proveskit/antenna-board/antenna_top_cap_v2d/jlcpcb/production_files/BOM-antenna_top_cap_v2d.csv

Comment | Designator | Footprint | LCSC | Quantity
ATB2012-50011-T000 | B1 | XFMR-SMD_ATB2012-50011-T000 | C92015 | 1
1uF | C201 | C_0603_1608Metric | C15849 | 1
22uF | C202 | C_0805_2012Metric | C45783 | 1
22uF | C204,C205,C206,C207 | C_1206_3216Metric | C12891 | 4
47nF | C208 | C_0603_1608Metric | C1622 | 1
4.7uF | C209 | C_0603_1608Metric | C19666 | 1
100nF | C43,C5 | C_0805_2012Metric | C28233 | 2
Blue | D1 | LED_0603_1608Metric | C2288 | 1
Green | D201 | LED_0805_2012Metric | C2297 | 1
Red | D202 | LED_0603_1608Metric | C2286 | 1
1.5A | F201 | Fuse_1206_3216Metric | C187598 | 1
DEBUG | J1 | Hirose_DF11-12DP-2DSA_2x06_P2.00mm_Vertical | C506658 | 1
DF11-4DP-2DSA | J11,J9 | Hirose_DF11-4DP-2DSA_2x02_P2.00mm_Vertical | C506665 | 2
USB_C_Receptacle_USB2.0_16P | J12,J204,J8 | USB_C_Receptacle_HRO_TYPE-C-31-M-12 | C165948 | 3
DNP | J13 | Hirose_DF11-4DP-2DSA_2x02_P2.00mm_Vertical |  | 1
SWD from FC | J201,J202 | JST_SH_BM03B-SRSS-TB_1x03-1MP_P1.00mm_Vertical | C160389 | 2
1uH | L201 | L_Changjiang_FNR4030S | C167865 | 1
CSD17576Q5B | Q2 | TDSON-8-1 | C2876547 | 1
10k | R1,R204 | R_0402_1005Metric | C25744 | 2
10k | R10,R11,R8,R9 | R_0603_1608Metric | C25804 | 4
3.9k | R201 | R_0402_1005Metric | C51721 | 1
820 | R202 | R_0402_1005Metric | C25135 | 1
0 | R203 | R_0402_1005Metric | C17168 | 1
12k | R205 | R_0402_1005Metric | C25752 | 1
4.7k | R206 | R_0603_1608Metric | C23162 | 1
2.2k | R207 | R_0603_1608Metric | C4190 | 1
5.1k | R208,R209,R26,R27,R5,R6 | R_0603_1608Metric | C23186 | 6
0 | R210 | R_1206_3216Metric | C17888 | 1
1M | R7 | R_0603_1608Metric | C22935 | 1
KH-MMCX-Z | RF1 | MMCX-TH_KH-MMCX-Z | C530664 | 1
BQ25886RGER | U201 | Texas_RGE0024H_VQFN-24-1EP_4x4mm_P0.5mm_EP2.7x2.7mm | C2765094 | 1
VEML6031X00 | U3 | SENSOR-SMD_VEML6031X00 | C3678616 | 1
TMP112xxDRL | U4 | SOT-563 | C3019122 | 1
TCA4311ADGKR | U6 | MSOP-8_L3.0-W3.0-P0.65-LS5.0-BL | C130025 | 1
