proveskit/antenna-board/antenna_top_cap_v2c/Extra Libraries Folder/CD74HC4050M96/CD74HC4050M96.step

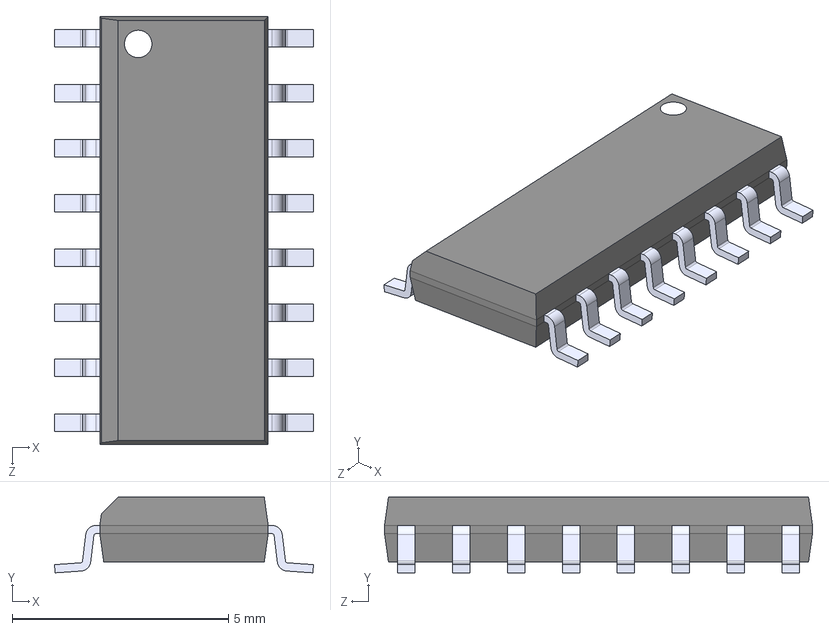
[picture p1: CAD file, 2026-09-02]
antenna_top_cap_v2c/Extra Libraries Folder/CD74HC4050M96/CD74HC4050M96.step
5.99 x 1.75 x 9.91 mm
