proveskit/antenna-board/antenna_top_cap_v2c/Extra Libraries Folder/LIB_AZ1117CH-3.3TRG1 (1)/AZ1117CH-3.3TRG1/3D/AZ1117CH-3.3TRG1.stp

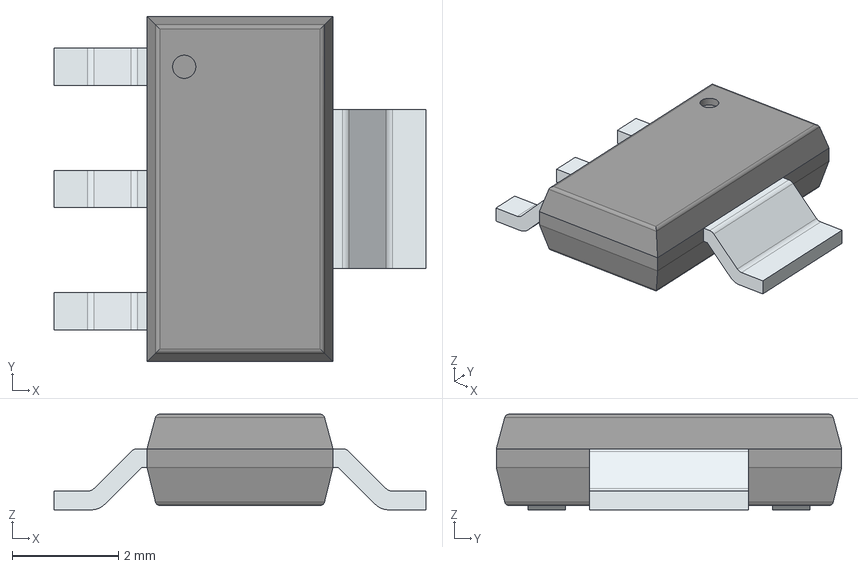
[picture p2: CAD file, 2026-09-02]
antenna_top_cap_v2c/Extra Libraries Folder/LIB_AZ1117CH-3.3TRG1 (1)/AZ1117CH-3.3TRG1/3D/AZ1117CH-3.3TRG1.stp
7.00 x 6.50 x 1.80 mm
PinsArrayL
FilletPinR
