proveskit/antenna-board/antenna_top_cap_v2c/Extra Libraries Folder/105164-0001 (1)/105164-0001.step

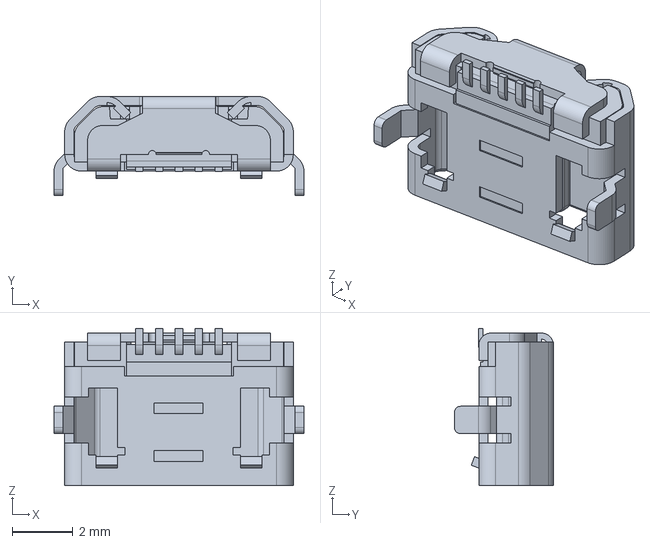
[picture p3: CAD file, 2026-09-02]
antenna_top_cap_v2c/Extra Libraries Folder/105164-0001 (1)/105164-0001.step
8.20 x 3.25 x 5.15 mm
