proveskit/antenna-board/antenna_top_cap_v2c/Extra Libraries Folder/504050-0291/504050-0291.step

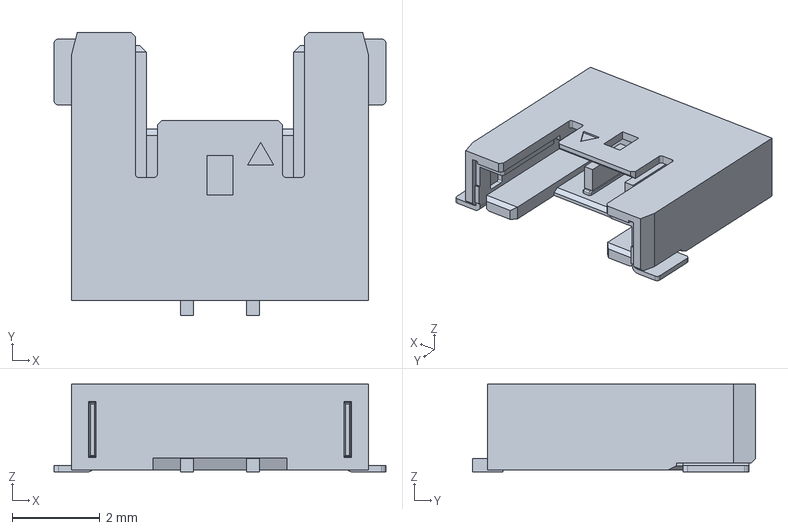
[picture p4: CAD file, 2026-09-02]
antenna_top_cap_v2c/Extra Libraries Folder/504050-0291/504050-0291.step
7.55 x 6.44 x 2.00 mm
