proveskit/antenna-board/antenna_top_cap_v2c/Extra Libraries Folder/LIB_104031-0811/104031-0811/3D/104031-0811.stp

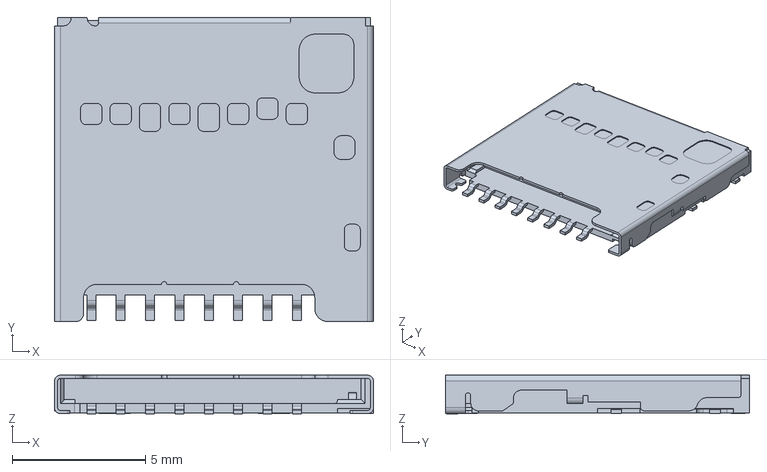
[picture p5: CAD file, 2026-09-02]
antenna_top_cap_v2c/Extra Libraries Folder/LIB_104031-0811/104031-0811/3D/104031-0811.stp
11.9 x 11.4 x 1.45 mm
