proveskit/antenna-board/(list of files, cad)

Other CAD files:
antenna_top_cap_v2c/Extra Libraries Folder/LIB_104031-0811/104031-0811/Allegro/1040310811.psm
antenna_top_cap_v2c/Extra Libraries Folder/LIB_104031-0811/104031-0811/DEHDL/104031_0811/chips/chips.prt
antenna_top_cap_v2c/Extra Libraries Folder/LIB_AZ1117CH-3.3TRG1 (1)/AZ1117CH-3.3TRG1/Allegro/sot230p700x180-4n.psm
antenna_top_cap_v2c/Extra Libraries Folder/LIB_AZ1117CH-3.3TRG1 (1)/AZ1117CH-3.3TRG1/DEHDL/az1117ch_3.3trg1/chips/chips.prt
