proveskit/antenna-board/(threads)

Thread 1 (2024-06-18):

Selecting the Location of the 12-Pin Picolock

Mikefly123, 2024-06-18:
I have initially placed it towards the center of the board, but Pragun has requested it move like the attached image. Any thoughts?

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

Mikefly123, 2024-06-19:
Testing out this team thing. @proveskit/avionics-team

Closed 2024-07-16.

Thread 2 (2024-06-18):

Auxiliary Antenna Feed Path Causing Huge Losses

Mikefly123, 2024-06-18:
So the way that we are currently doing the Aux Radio Module Antenna feed seems to be causing huge losses compared to just a straight feed path. Somewhere in the neighborhood of -10 to -14dB in the RSSI in our testing at the lab. We need to address this, probably by changing out the RF switch IC being used to have it inline rather than off to the side.

Thread 3 (2024-06-18):

Our Baluns Are Hoodwinking Us!

Mikefly123, 2024-06-18:
For the last two years we have been kind of blindly using whatever Balun looks like it has a decent insertion loss for our intended frequency. The problem with this is that we didn't really have a great understanding of what Baluns actually do and how they work.

Because we have been trying to use 1:4 Baluns like this:

https://www.johansontechnology.com/datasheets/0433BM15A0001/0433BM15A0001.pdf

We are running into an impedance mismatch on the balanced port. Parts like the above linked balun output 200 Ohms on the balanced port, whereas we really want something that is closer to the 72 ohm impedance of an ideal dipole.

Mikefly123, 2024-06-18:
We might want to swap to a part like this?

https://www.minicircuits.com/pdfs/NCS1.5-232+.pdf

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

More Research Needed

Mikefly123, 2024-06-18:
Also, a reference to what the title means haha

https://youtu.be/-B3gjf0sREk?si=o_he7N_A1IsG9HRs

Mikefly123, 2024-06-20:
Confirming that we are swapping to the NCS1.5-232+ for future antenna boards. Updates to the schematic and layout for this have been made in Commit https://github.com/proveskit/antenna-board/commit/264a7582f32f4466c49b9e7e7279876b0408b85f

Mikefly123, 2024-06-20:
This update will merge with main after Issue #4 is complete!

Closed 2024-06-20.

Thread 4 (2024-06-19):

Antenna Top Cap Version 2

Mikefly123, 2024-06-19:
Whipping up an entirely new version of the antenna top cap! Hoping to significantly improve the antenna feed path with better part selection and also roll up significant quality of life improvements by consolidating many of the connectors.

Mikefly123, 2024-06-19:
First major update is the schematic. See details in Issue #5

Closed 2024-06-24.

Thread 5 (2024-06-19):

Confusing Schematic

Mikefly123, 2024-06-19:
The usual, our first version has a very confusingly laid out schematic. See attached:
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

Mikefly123, 2024-06-19:
This was fixed for V2 in Commit https://github.com/proveskit/antenna-board/commit/d93f40ee3b1451b6ce820f76784fe6274ac24dea.

See the new schematic here!
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

Closed 2024-06-19.

Thread 6 (2024-06-20):

All of the SDA1 Nets Have Been Renamed to SCL1

Mikefly123, 2024-06-20:
This is really annoying, not sure why this happened! We might have to reroute everything:

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

Mikefly123, 2024-06-20:
# Hotfix

Hotfixed by renaming the nets from SCL to SDA. This appears to have corrected everything. We need to make sure to verify all the connections before shipping!

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

NicoleMaggard, 2024-06-20:
Before:
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
After:
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

Closed 2024-06-20.

Thread 7 (2024-06-20):

5 position picolock suggestion

NicoleMaggard, 2024-06-20:
you should totally add a 5 position picolock header for the flight computer to communicate with the USB pins similar to how the 12 position picolock is setup for the battery board

Mikefly123, 2024-06-24:
It is done

Closed 2024-06-24.

Thread 9 (2024-06-23):

RBF Hole Spacing on the Antenna Board

Mikefly123, 2024-06-23:
Is the spacing on these holes correct or do they need to be spread out more?

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

Thread 11 (2024-07-07):

C1 Clearance

Mikefly123, 2024-07-07:
The C1 Capacitor on the Antenna Board is too close to the 12-pos Molex connector. It doesn't block insertion but makes it awkward.
