proveskit/antenna-board/(list of files, drawings)

Other design files:
antenna_top_cap_v2c/Extra Libraries Folder/LIB_104031-0811/104031-0811/Altium/104031-0811.SchLib
antenna_top_cap_v2c/Extra Libraries Folder/LIB_104031-0811/104031-0811/Altium/1040310811.PcbLib
antenna_top_cap_v2c/Extra Libraries Folder/LIB_AZ1117CH-3.3TRG1 (1)/AZ1117CH-3.3TRG1/Altium/AZ1117CH-3.3TRG1.SchLib
antenna_top_cap_v2c/Extra Libraries Folder/LIB_AZ1117CH-3.3TRG1 (1)/AZ1117CH-3.3TRG1/Altium/SOT230P700X180-4N.PcbLib
