proveskit/antenna-board/antenna_top_cap_v2d/antenna_top_cap_v2d.kicad_pcb

## KiCad design antenna_top_cap_v2d/antenna_top_cap_v2d.kicad_pcb (2026-11-12)

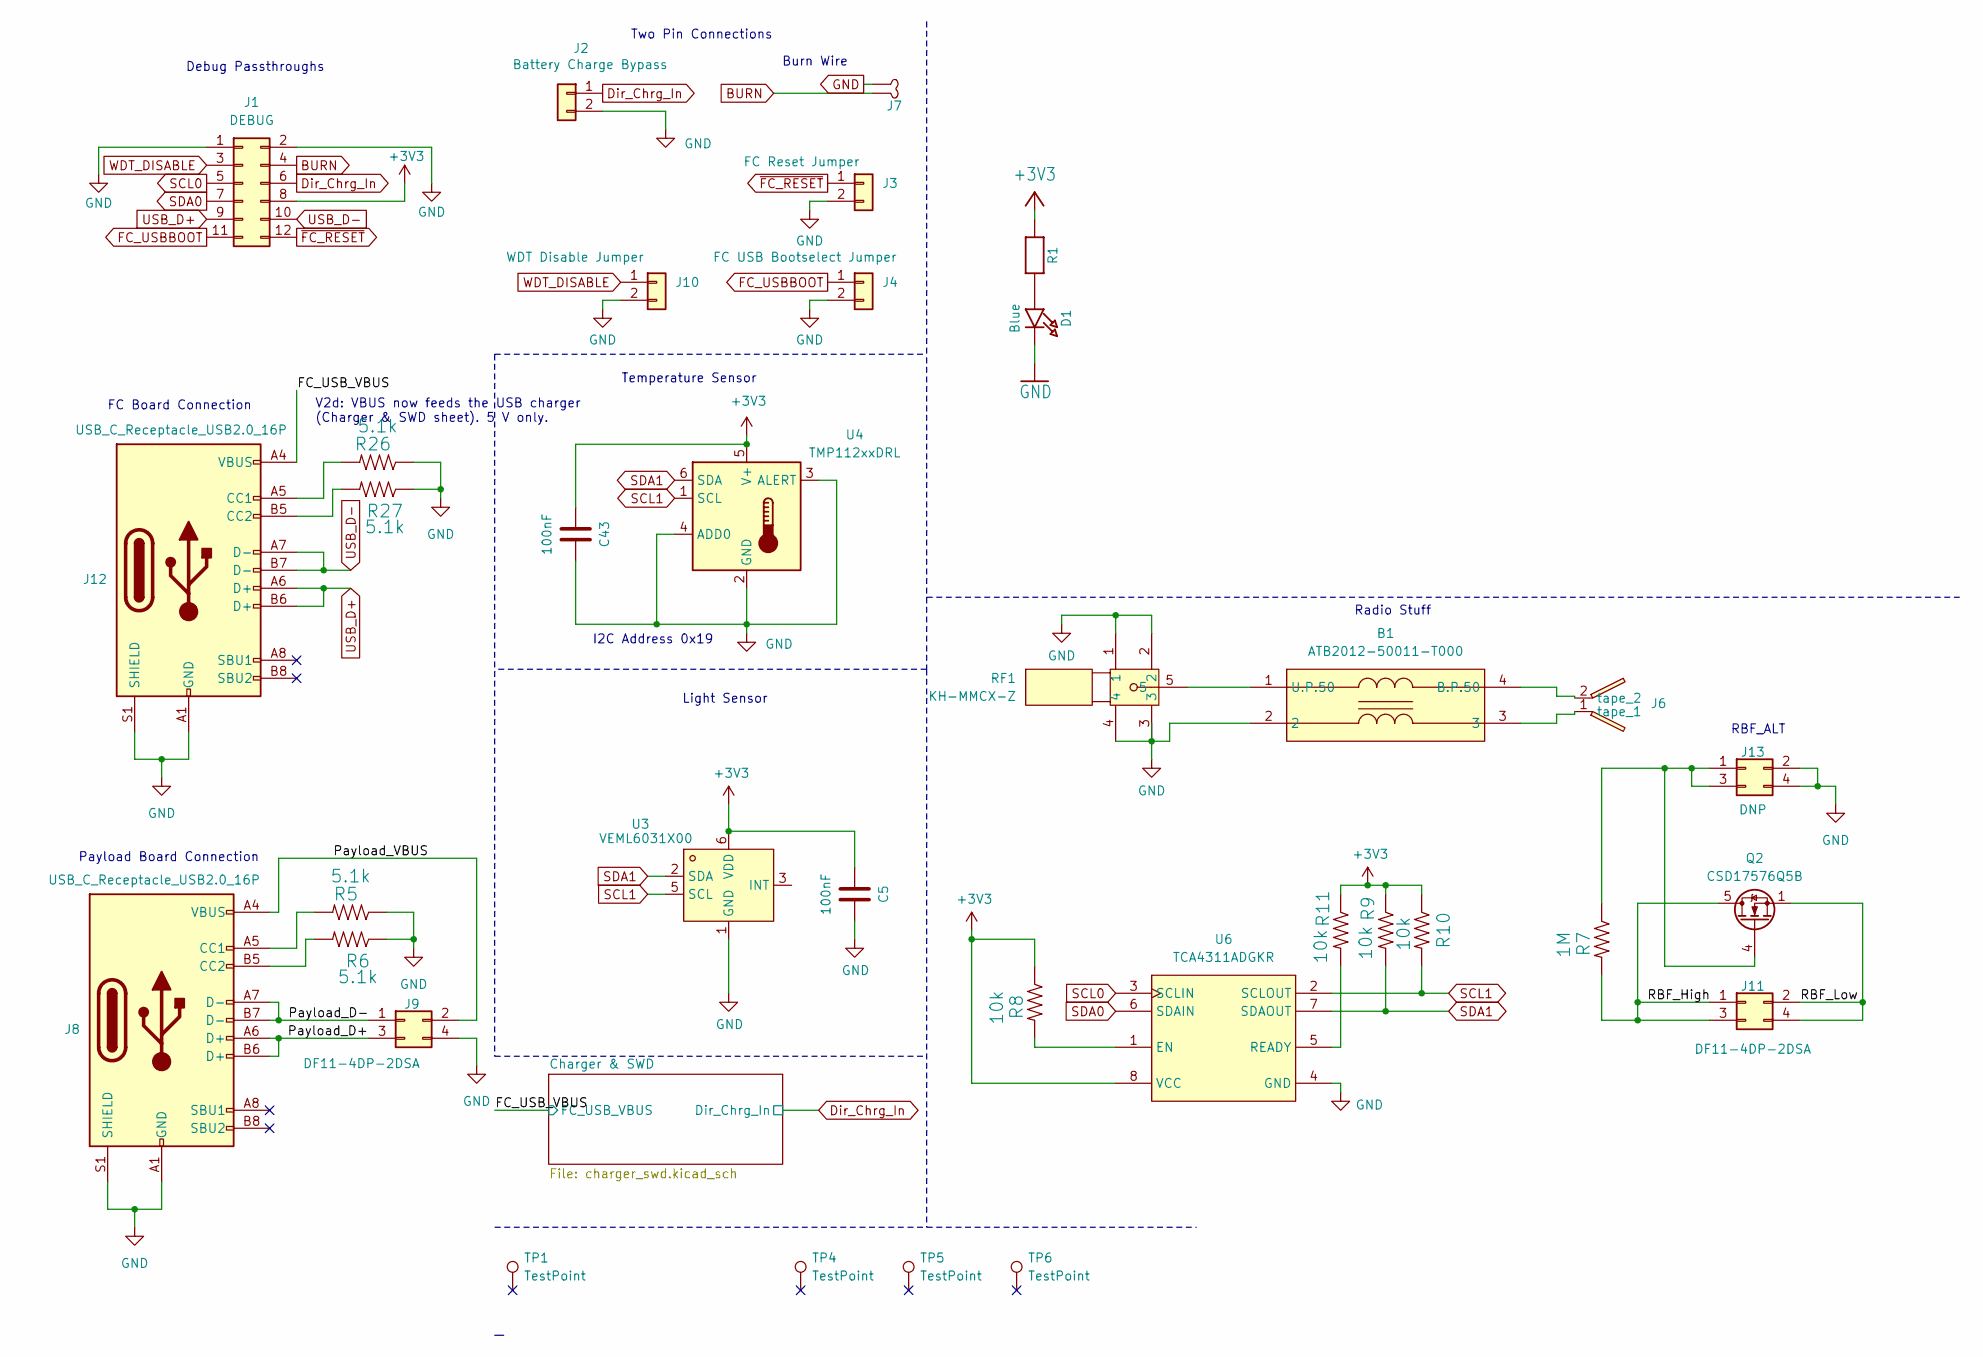
[picture p6: schematic antenna_top_cap_v2d.kicad_sch, PROVES Antenna Board V2d]

Parts:
B1: ATB2012-50011-T000; XFMR-SMD_ATB2012-50011-T000; LCSC Part C92015
C5, C43: 100nF; C_0805_2012Metric
D1: Blue; LED_0603_1608Metric
J1: DEBUG; Hirose_DF11-12DP-2DSA_2x06_P2.00mm_Vertical
J2: Battery Charge Bypass; PinHeader_1x02_P2.54mm_Vertical
J3: FC Reset Jumper; PinHeader_1x02_P2.54mm_Vertical
J4: FC USB Bootselect Jumper; PinHeader_1x02_P2.54mm_Vertical
J6: Tape_Measure_Antenna
J7: Burn_Wire
J8, J12: USB_C_Receptacle_USB2.0_16P; USB_C_Receptacle_HRO_TYPE-C-31-M-12
J9, J11: DF11-4DP-2DSA; Hirose_DF11-4DP-2DSA_2x02_P2.00mm_Vertical
J10: WDT Disable Jumper; PinHeader_1x02_P2.54mm_Vertical
J13: DNP; Hirose_DF11-4DP-2DSA_2x02_P2.00mm_Vertical
Q2: CSD17576Q5B; TDSON-8-1
R1: 10k; R_0402_1005Metric
R5, R6, R26, R27: 5.1k; R_0603_1608Metric
R7: 1M; R_0603_1608Metric
R8, R9, R10, R11: 10k; R_0603_1608Metric
RF1: KH-MMCX-Z; MMCX-TH_KH-MMCX-Z; LCSC Part C530664
TP1, TP4, TP5, TP6: TestPoint; MountingHole_2.7mm_M2.5_Pad
U3: VEML6031X00; SENSOR-SMD_VEML6031X00; LCSC Part C3678616
U4: TMP112xxDRL; SOT-563
U6: TCA4311ADGKR; MSOP-8_L3.0-W3.0-P0.65-LS5.0-BL; LCSC Part C130025

Connections:
+3V3: C5.1, C43.1, J1.8, R1.1, R8.1, R9.1, R10.1, R11.1, U3.6 (VDD), U4.5 (V+), U6.8 (VCC)
/Payload_D+: J8.A6 (D+), J8.B6 (D+), J9.3
/Payload_D-: J8.A7 (D-), J8.B7 (D-), J9.1
/Payload_VBUS: J8.A4 (VBUS), J8.A9 (VBUS), J8.B4 (VBUS), J8.B9 (VBUS), J9.2
/RBF_High: J11.1, J11.3, Q2.5 (D), R7.2
/RBF_Low: J11.2, J11.4, Q2.1 (S), Q2.2 (S), Q2.3 (S)
BURN: J1.4, J7.1 (Power)
Dir_Chrg_In: J1.6, J2.1; also elsewhere on the board
FC_USBBOOT: J1.11, J4.1
GND: B1.2, C5.2, C43.2, D1.2 (C), J1.1, J1.2, J2.2, J3.2, J4.2, J7.2 (GND), J8.A1 (GND), J8.A12 (GND), J8.B1 (GND), J8.B12 (GND), J8.S1 (SHIELD), J9.4, J10.2, J12.A1 (GND), J12.A12 (GND), J12.B1 (GND), J12.B12 (GND), J12.S1 (SHIELD), J13.2, J13.4, R5.1, R6.1, R26.1, R27.1, RF1.1, RF1.2, RF1.3, RF1.4, U3.1 (GND), U3.4 (GND), U4.2 (GND), U4.3 (ALERT), U4.4 (ADD0), U6.4 (GND); also elsewhere on the board
unnamed: B1.4 (B.P.50), J6.2 (tape)
unnamed: B1.1 (U.P.50), RF1.5
unnamed: D1.1 (A), R1.2
unnamed: B1.3, J6.1 (tape)
unnamed: J8.A5 (CC1), R5.2
unnamed: J8.B5 (CC2), R6.2
unnamed: J12.A5 (CC1), R26.2
unnamed: J12.B5 (CC2), R27.2
unnamed: J13.1, J13.3, Q2.4 (G), R7.1
unnamed: R8.2, U6.1 (EN)
unnamed: R11.2, U6.5 (READY)
SCL0: J1.5, U6.3 (SCLIN)
SCL1: R10.2, U3.5 (SCL), U4.1 (SCL), U6.2 (SCLOUT)
SDA0: J1.7, U6.6 (SDAIN)
SDA1: R9.2, U3.2 (SDA), U4.6 (SDA), U6.7 (SDAOUT)
USB_D+: J1.9, J12.A6 (D+), J12.B6 (D+)
USB_D-: J1.10, J12.A7 (D-), J12.B7 (D-)
WDT_DISABLE: J1.3, J10.1
~FC_RESET: J1.12, J3.1

Notes on the sheet:
Light Sensor
Two Pin Connections
I2C Address 0x19
Radio Stuff
Debug Passthroughs
FC Board Connection
RBF_ALT
Payload Board Connection
Burn Wire
Temperature Sensor
V2d: VBUS now feeds the USB charger (Charger & SWD sheet). 5 V only.

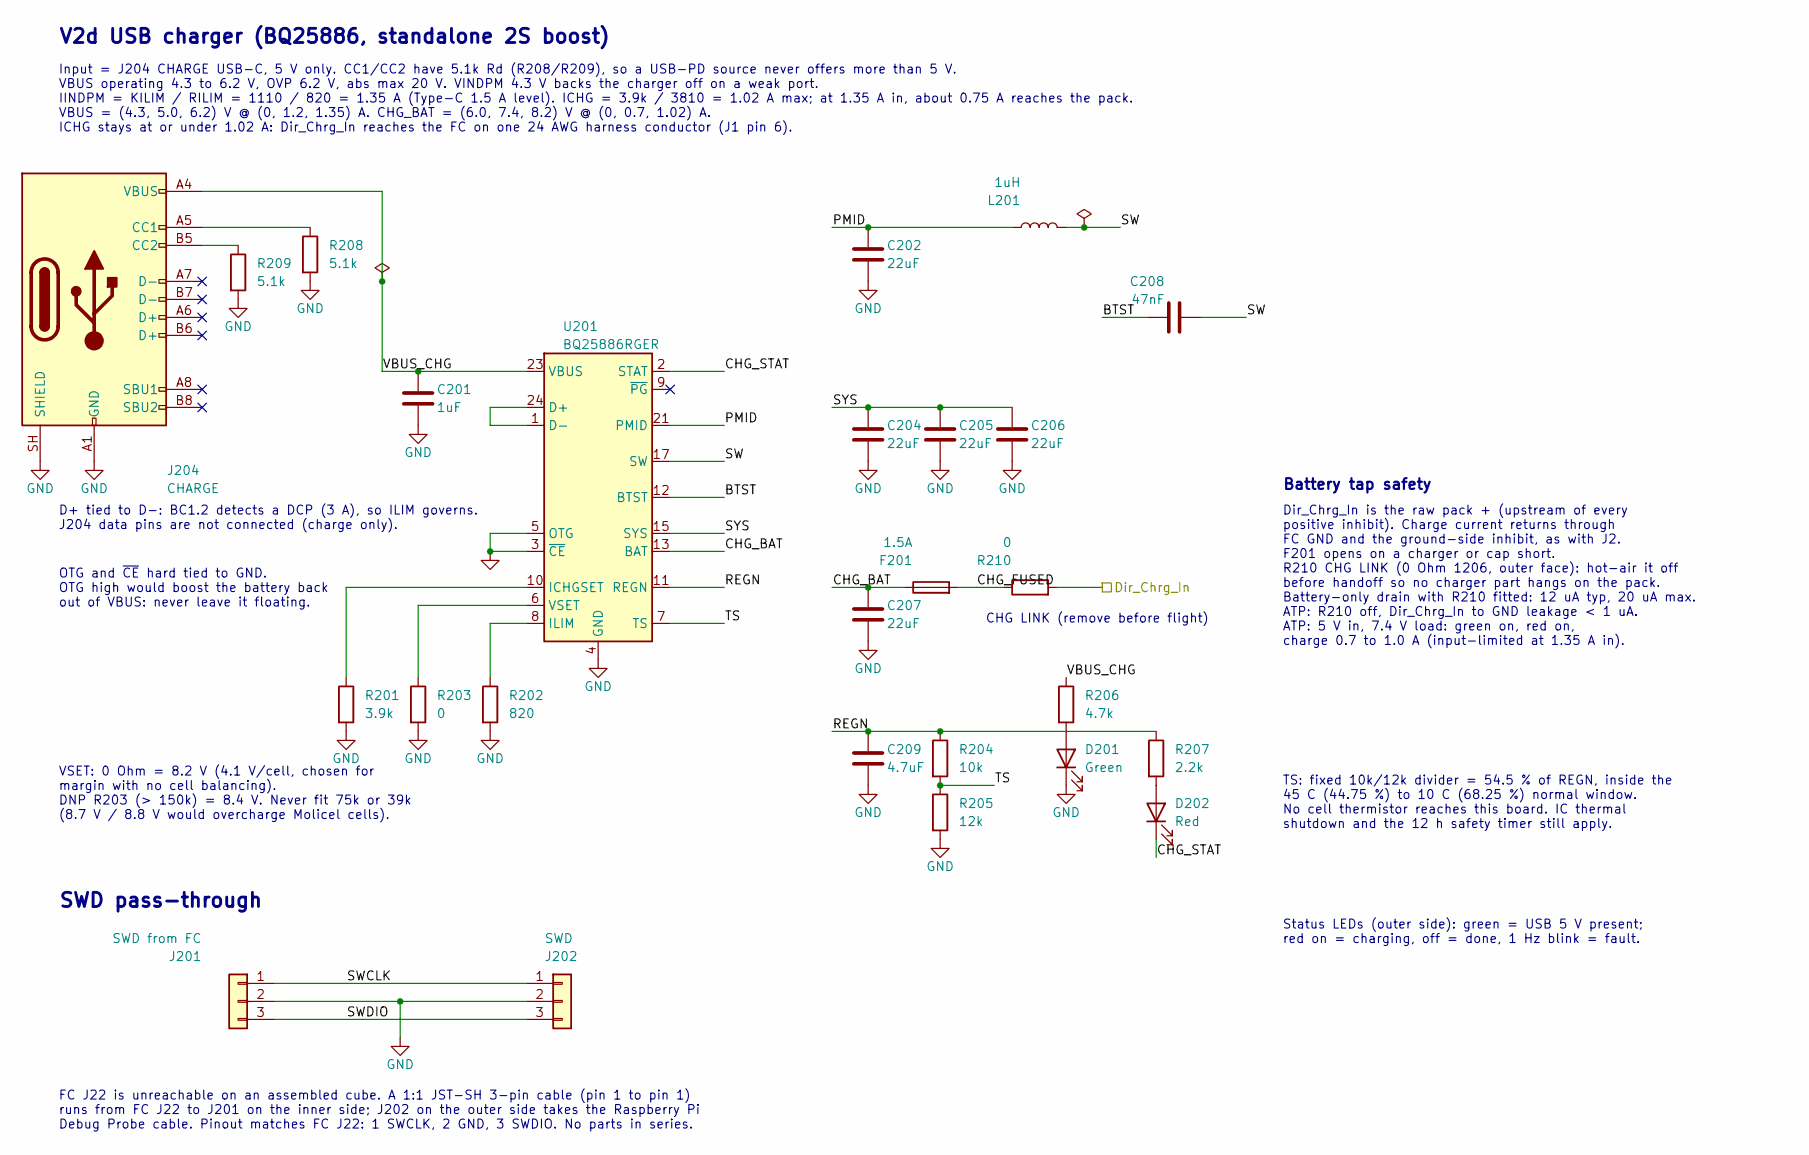
[picture p7: schematic charger_swd.kicad_sch, Antenna Board V2d: USB charger and SWD pass-through]

Parts:
C201: 1uF; C_0603_1608Metric; LCSC C15849
C202: 22uF; C_0805_2012Metric; LCSC C45783
C204, C205, C206, C207: 22uF; C_1206_3216Metric; LCSC C12891
C208: 47nF; C_0603_1608Metric; LCSC C1622
C209: 4.7uF; C_0603_1608Metric; LCSC C19666
D201: Green; LED_0805_2012Metric; LCSC C2297
D202: Red; LED_0603_1608Metric; LCSC C2286
F201: 1.5A; Fuse_1206_3216Metric; MPN 046601.5NRHF; LCSC C187598
J201: SWD from FC; JST_SH_BM03B-SRSS-TB_1x03-1MP_P1.00mm_Vertical; MPN BM03B-SRSS-TB(LF)(SN); LCSC C160389
J202: SWD; JST_SH_BM03B-SRSS-TB_1x03-1MP_P1.00mm_Vertical; MPN BM03B-SRSS-TB(LF)(SN); LCSC C160389
J204: CHARGE; USB_C_Receptacle_HRO_TYPE-C-31-M-12; MPN TYPE-C-31-M-12; LCSC C165948
L201: 1uH; L_Changjiang_FNR4030S; MPN FNR4030S1R0MT; LCSC C167865
R201: 3.9k; R_0402_1005Metric; LCSC C51721
R202: 820; R_0402_1005Metric; LCSC C25135
R203: 0; R_0402_1005Metric; LCSC C17168
R204: 10k; R_0402_1005Metric; LCSC C25744
R205: 12k; R_0402_1005Metric; LCSC C25752
R206: 4.7k; R_0603_1608Metric; LCSC C23162
R207: 2.2k; R_0603_1608Metric; LCSC C4190
R208, R209: 5.1k; R_0603_1608Metric; LCSC C23186
R210: 0; R_1206_3216Metric; LCSC C17888
U201: BQ25886RGER; Texas_RGE0024H_VQFN-24-1EP_4x4mm_P0.5mm_EP2.7x2.7mm; LCSC C2765094

Connections:
/Charger & SWD/BTST: C208.1, U201.12 (BTST)
/Charger & SWD/CHG_BAT: C207.1, F201.1, U201.13 (BAT), U201.14 (BAT)
/Charger & SWD/CHG_FUSED: F201.2, R210.1
/Charger & SWD/CHG_STAT: D202.1 (K), U201.2 (STAT)
/Charger & SWD/PMID: C202.1, L201.1, U201.21 (PMID), U201.22 (PMID)
/Charger & SWD/REGN: C209.1, R204.1, R207.1, U201.11 (REGN)
/Charger & SWD/SW: C208.2, L201.2, U201.17 (SW), U201.18 (SW)
/Charger & SWD/SWCLK: J201.1, J202.1
/Charger & SWD/SWDIO: J201.3, J202.3
/Charger & SWD/SYS: C204.1, C205.1, C206.1, U201.15 (SYS), U201.16 (SYS)
/Charger & SWD/TS: R204.2, R205.1, U201.7 (TS)
/Charger & SWD/VBUS_CHG: C201.1, J204.A4 (VBUS), J204.A9 (VBUS), J204.B4 (VBUS), J204.B9 (VBUS), R206.1, U201.23 (VBUS)
Dir_Chrg_In: R210.2; also elsewhere on the board
GND: C201.2, C202.2, C204.2, C205.2, C206.2, C207.2, C209.2, D201.1 (K), J201.2, J202.2, J204.A1 (GND), J204.A12 (GND), J204.B1 (GND), J204.B12 (GND), J204.SH (SHIELD), R201.2, R202.2, R203.2, R205.2, R208.2, R209.2, U201.3 (~CE), U201.4 (GND), U201.5 (OTG), U201.19 (GND), U201.20 (GND), U201.25 (GND); also elsewhere on the board
unnamed: D201.2 (A), R206.2
unnamed: D202.2 (A), R207.2
unnamed: J204.A5 (CC1), R208.1
unnamed: J204.B5 (CC2), R209.1
unnamed: U201.1 (D-), U201.24 (D+)
unnamed: R201.1, U201.10 (ICHGSET)
unnamed: R202.1, U201.8 (ILIM)
unnamed: R203.1, U201.6 (VSET)

Notes on the sheet:
CHG LINK (remove before flight)
V2d USB charger (BQ25886, standalone 2S boost)
Input = J204 CHARGE USB-C, 5 V only. CC1/CC2 have 5.1k Rd (R208/R209), so a USB-PD source never offers more than 5 V. VBUS operating 4.3 to 6.2 V, OVP 6.2 V, abs max 20 V. VINDPM 4.3 V backs the charger off on a weak port. IINDPM = KILIM / RILIM = 1110 / 820 = 1.35 A (Type-C 1.5 A level). ICHG = 3.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
D+ tied to D-: BC1.2 detects a DCP (3 A), so ILIM governs. J204 data pins are not connected (charge only).
OTG and ~{CE} hard tied to GND. OTG high would boost the battery back out of VBUS: never leave it floating.
VSET: 0 Ohm = 8.2 V (4.1 V/cell, chosen for margin with no cell balancing). DNP R203 (> 150k) = 8.4 V. Never fit 75k or 39k (8.7 V / 8.8 V would overcharge Molicel cells).
TS: fixed 10k/12k divider = 54.5 % of REGN, inside the 45 C (44.75 %) to 10 C (68.25 %) normal window. No cell thermistor reaches this board. IC thermal shutdown and the 12 h safety timer still apply.
Battery tap safety
Dir_Chrg_In is the raw pack + (upstream of every positive inhibit). Charge current returns through FC GND and the ground-side inhibit, as with J2. F201 opens on a charger or cap short. R210 CHG LINK (0 Ohm 1206, outer face): hot-air it off before handoff so no charger part hangs on the pack. Batter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
Status LEDs (outer side): green = USB 5 V present; red on = charging, off = done, 1 Hz blink = fault.
SWD pass-through
FC J22 is unreachable on an assembled cube. A 1:1 JST-SH 3-pin cable (pin 1 to pin 1) runs from FC J22 to J201 on the inner side; J202 on the outer side takes the Raspberry Pi Debug Probe cable. Pinout matches FC J22: 1 SWCLK, 2 GND, 3 SWDIO. No parts in series.

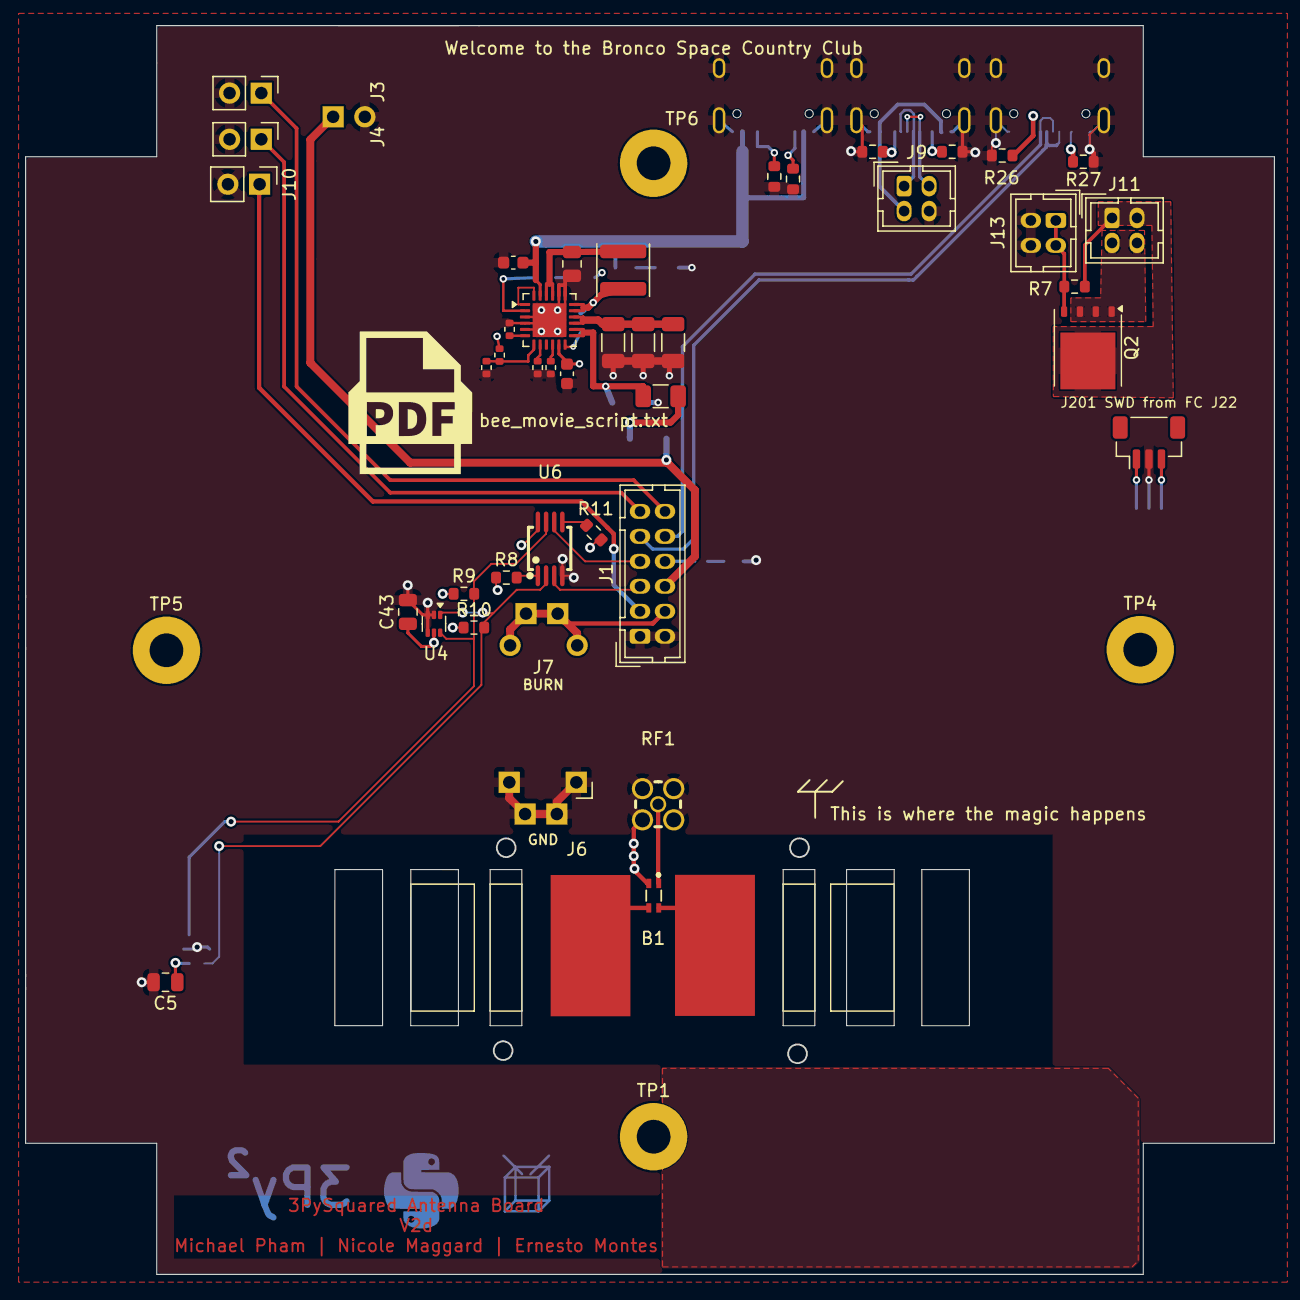
[picture p8: board antenna_top_cap_v2d.kicad_pcb from above]

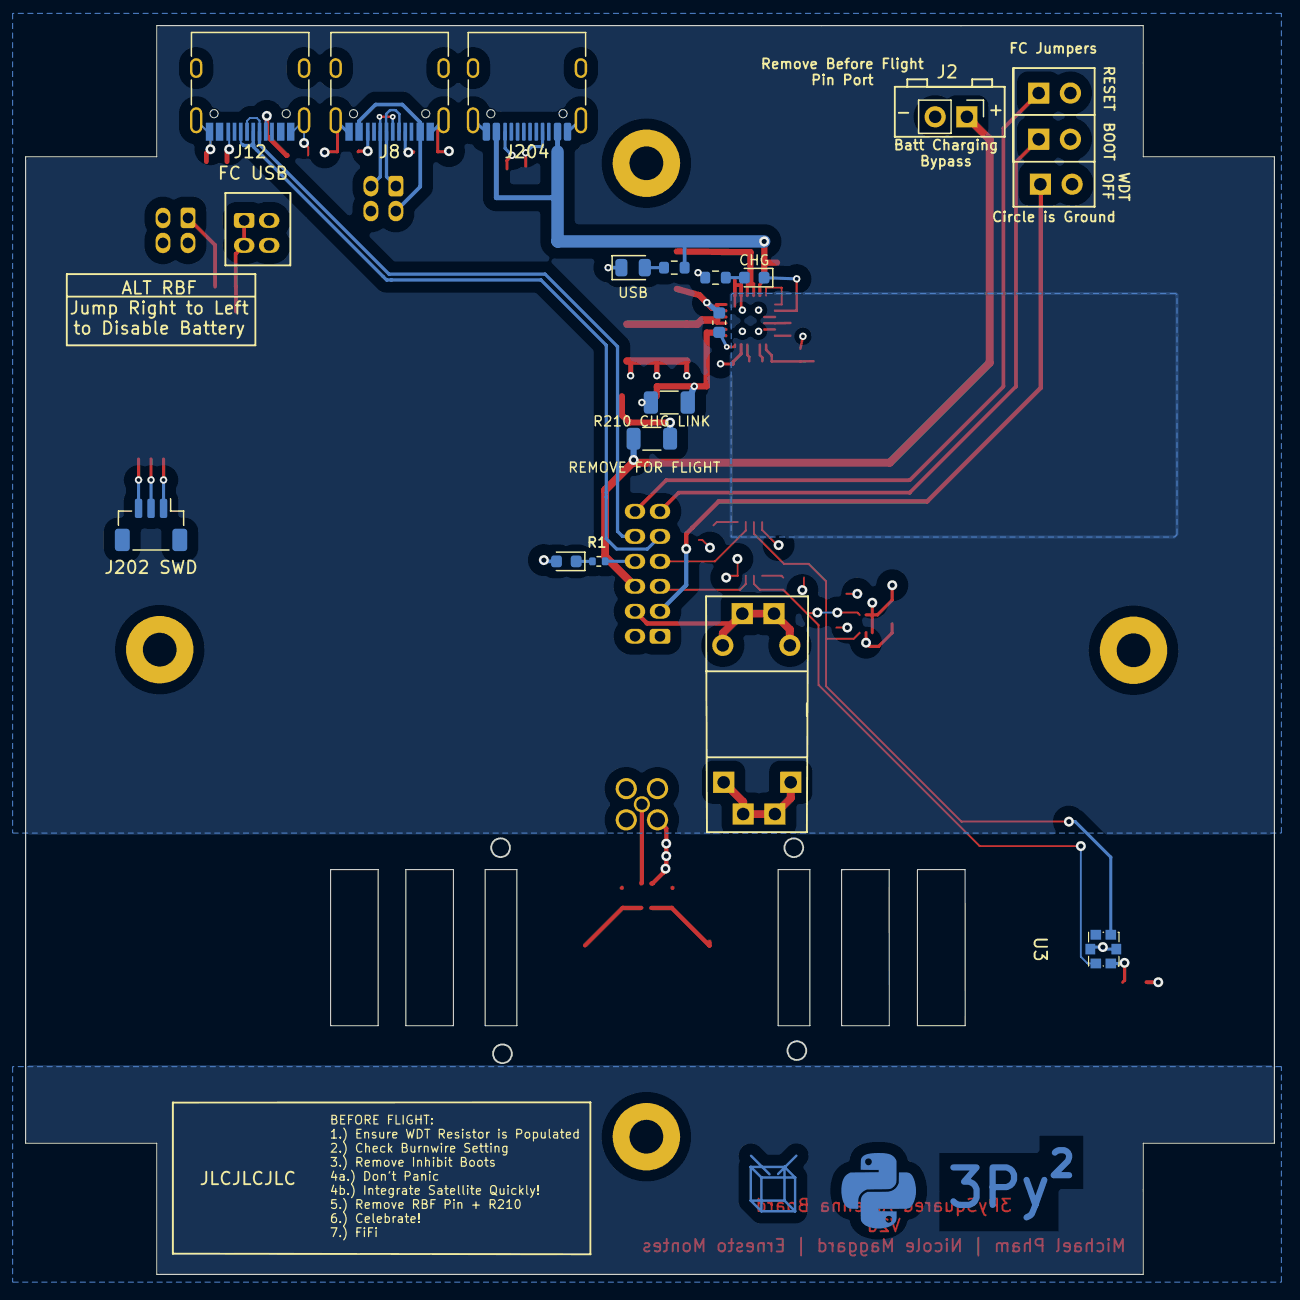
[picture p9: board antenna_top_cap_v2d.kicad_pcb from below]

Board: 4 copper layers, 100.0 x 100.0 mm, 61 parts (15 on the bottom side), 49 nets.
