proveskit/antenna-board/debug_board_v1/debug_board_v1.kicad_pcb

## KiCad design debug_board_v1/debug_board_v1.kicad_pcb (2026-04-07)

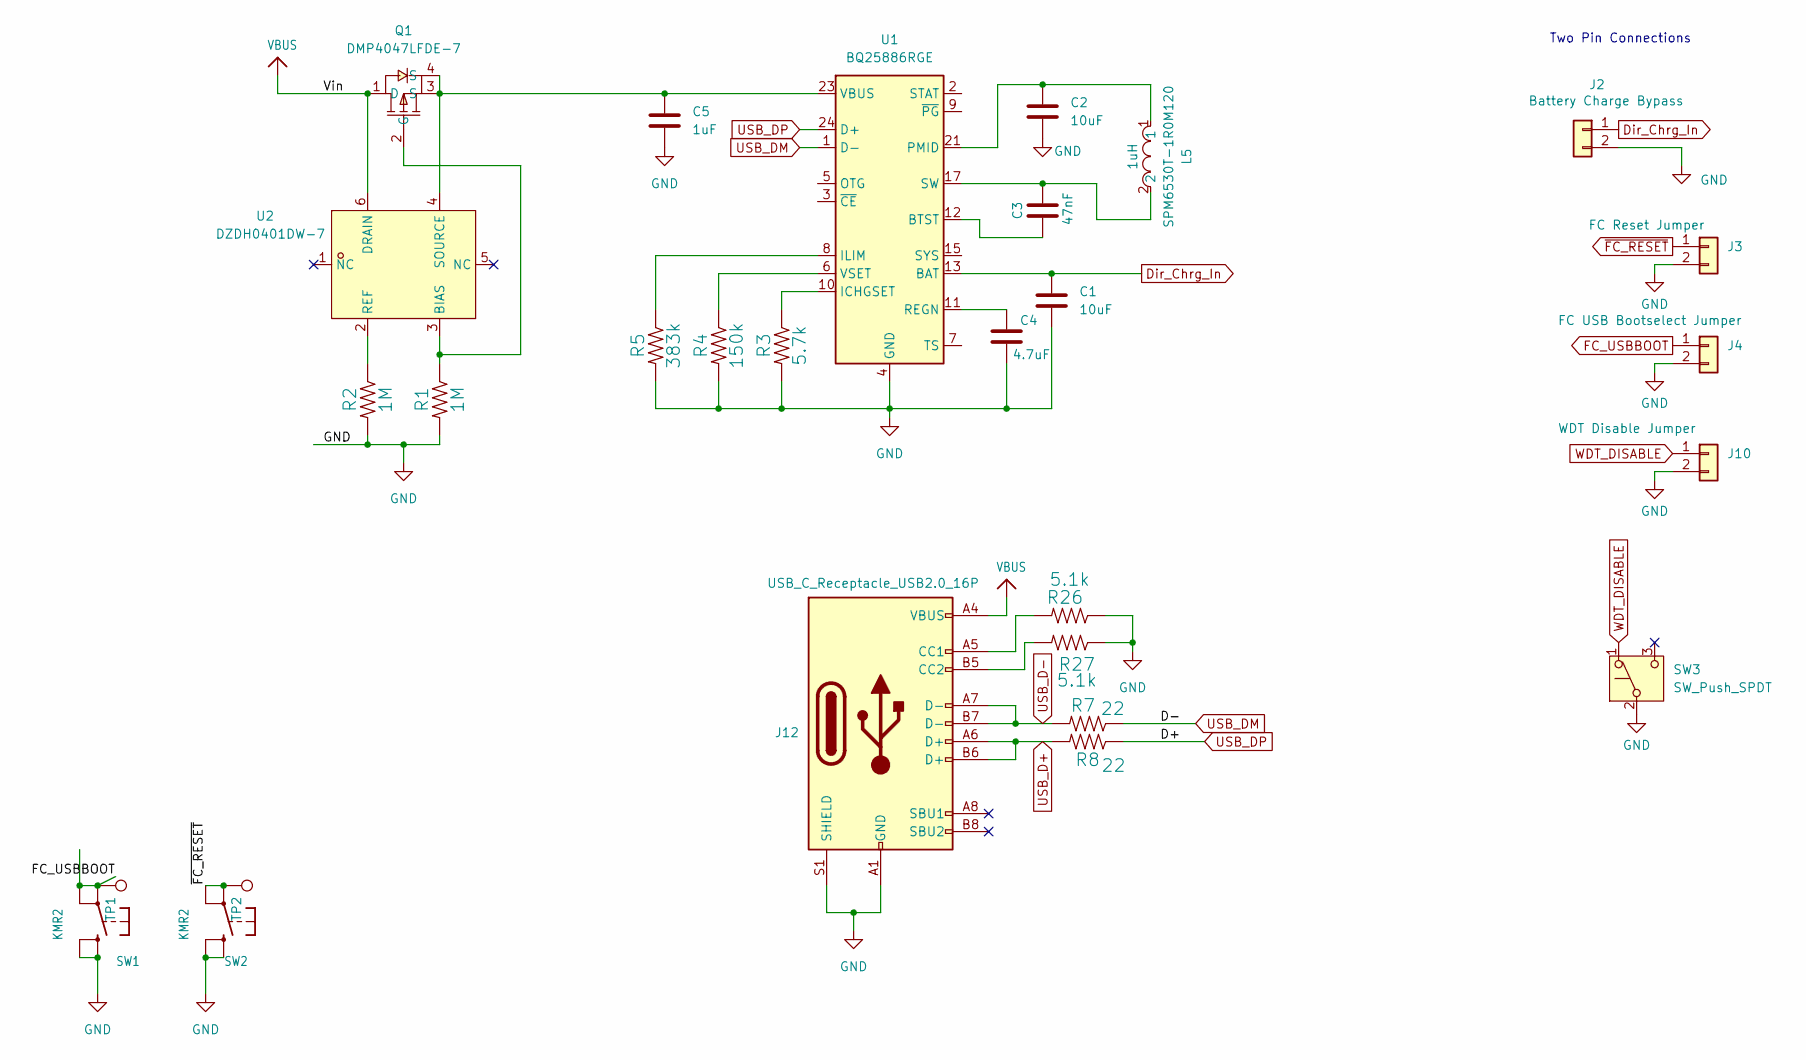
[picture p10: schematic debug_board_v1.kicad_sch]

Parts:
C1, C2: 10uF; C_0603_1608Metric
C3: 47nF; C_0603_1608Metric
C4: 4.7uF; C_0603_1608Metric
C5: 1uF; C_0603_1608Metric
J2: Battery Charge Bypass; PinHeader_1x02_P2.54mm_Vertical
J3: FC Reset Jumper; PinHeader_1x02_P2.54mm_Vertical
J4: FC USB Bootselect Jumper; PinHeader_1x02_P2.54mm_Vertical
J10: WDT Disable Jumper; PinHeader_1x02_P2.54mm_Vertical
J12: USB_C_Receptacle_USB2.0_16P; USB_C_Receptacle_HRO_TYPE-C-31-M-12
L5: SPM6530T-1R0M120; IND-SMD_L7.1-W6.5-P5.60; LCSC Part C87572
Q1: DMP4047LFDE-7; U-DFN2020-6E_L2.0-W2.0-P0.65-BL; LCSC Part C442635
R1, R2: 1M; R_0603_1608Metric
R3: 5.7k; R_0603_1608Metric
R4: 150k; R_0603_1608Metric
R5: 383k; R_0603_1608Metric
R7, R8: 22; R_0402_1005Metric
R26, R27: 5.1k; R_0603_1608Metric
SW1, SW2: KMR2; BTN_KMR2_4.6X2.8
SW3: SW_Push_SPDT; SW-TH_SHOU-HAN_SS12D10G4
TP1: USBBOOT; TestPoint_Loop_D1.80mm_Drill1.0mm_Beaded
TP2: RESET; TestPoint_Loop_D1.80mm_Drill1.0mm_Beaded
U1: BQ25886RGE; Texas_RGE0024H_VQFN-24-1EP_4x4mm_P0.5mm_EP2.7x2.7mm
U2: DZDH0401DW-7; SOT-363_L2.0-W1.3-P0.65-LS2.1-BR; LCSC Part C3235552

Connections:
Dir_Chrg_In: C1.1, J2.1, U1.13 (BAT), U1.14 (BAT)
FC_USBBOOT: J4.1, SW1.A, SW1.A' (P1), TP1.1
GND: C1.2, C2.2, C4.2, C5.2, J2.2, J3.2, J4.2, J10.2, J12.A1 (GND), J12.A12 (GND), J12.B1 (GND), J12.B12 (GND), J12.S1 (SHIELD), R1.2, R2.2, R3.2, R4.2, R5.2, R26.1, R27.1, SW1.B (S), SW1.B' (S1), SW2.B (S), SW2.B' (S1), SW3.2 (B), U1.4 (GND), U1.19 (GND), U1.20 (GND), U1.25 (GND)
unnamed: C2.1, L5.1, U1.21 (PMID), U1.22 (PMID)
unnamed: C3.2, L5.2, U1.17 (SW), U1.18 (SW)
unnamed: J12.A5 (CC1), R26.2
unnamed: J12.B5 (CC2), R27.2
unnamed: Q1.2 (G), R1.1, U2.3 (BIAS)
unnamed: C3.1, U1.12 (BTST)
unnamed: R3.1, U1.10 (ICHGSET)
unnamed: R5.1, U1.8 (ILIM)
unnamed: C4.1, U1.11 (REGN)
unnamed: U1.15 (SYS), U1.16 (SYS)
unnamed: C5.1, Q1.3 (S), Q1.4 (S), U1.23 (VBUS), U2.4 (SOURCE)
unnamed: R4.1, U1.6 (VSET)
unnamed: R2.1, U2.2 (REF)
USB_D+: J12.A6 (D+), J12.B6 (D+), R8.2
USB_D-: J12.A7 (D-), J12.B7 (D-), R7.2
USB_DM: R7.1, U1.1 (D-)
USB_DP: R8.1, U1.24 (D+)
VBUS: J12.A4 (VBUS), J12.A9 (VBUS), J12.B4 (VBUS), J12.B9 (VBUS), Q1.1 (D), U2.6 (DRAIN)
WDT_DISABLE: J10.1, SW3.1 (A)
~FC_RESET: J3.1, SW2.A, SW2.A' (P1), TP2.1

Notes on the sheet:
Two Pin Connections

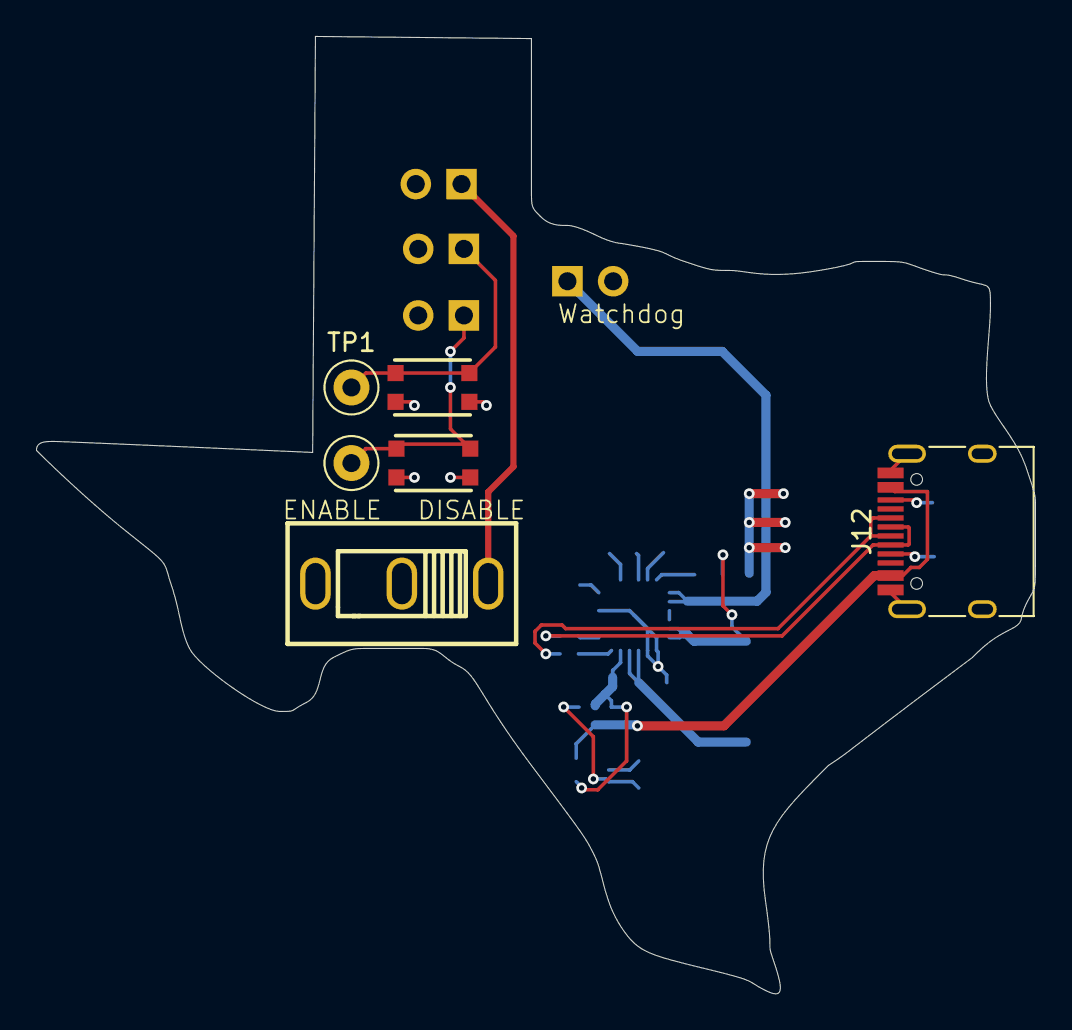
[picture p11: board debug_board_v1.kicad_pcb from above]

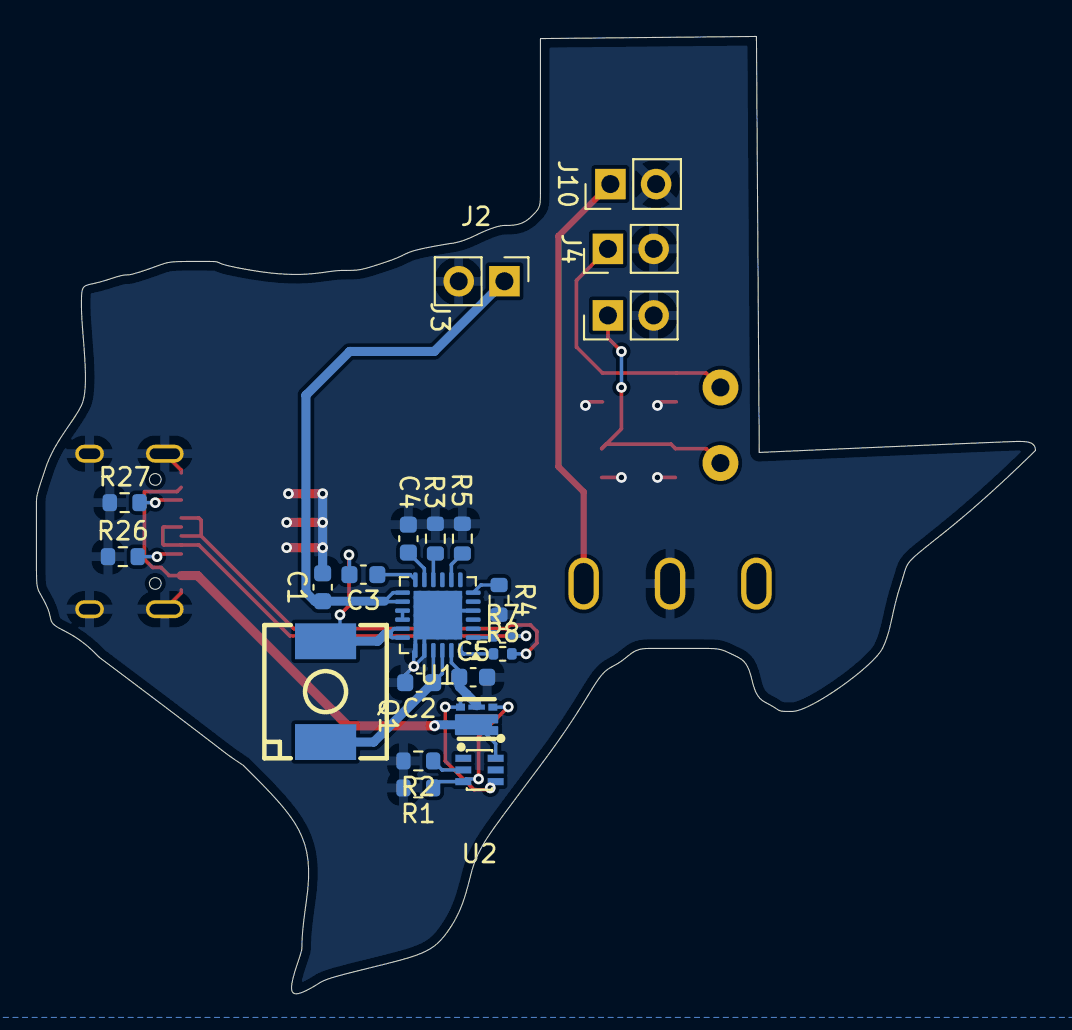
[picture p12: board debug_board_v1.kicad_pcb from below]

Board: 2 copper layers, 55.5 x 53.2 mm, 28 parts (22 on the bottom side), 23 nets.
