proveskit/antenna-board/(commit log)

2025-09-26 V2b: Switched From VEML7700 to VEML61
    [antenna_top_cap_v2b.kicad_pcb, antenna_top_cap_v2b.kicad_sch]
2025-10-08 As ORdered For V3 Pro
    [antenna_top_cap_v2b-CuBottom.gbr, antenna_top_cap_v2b-CuIn1.gbr, antenna_top_cap_v2b-CuIn2.gbr, antenna_top_cap_v2b-CuTop.gbr, antenna_top_cap_v2b-EdgeCuts.gbr, antenna_top_cap_v2b-MaskBottom.gbr, antenna_top_cap_v2b-MaskTop.gbr, antenna_top_cap_v2b-NPTH.drl]
2026-04-07 More Debug Board Work!
    [debug_board_v1-CuBottom.gbr, debug_board_v1-CuTop.gbr, debug_board_v1-EdgeCuts.gbr, debug_board_v1-MaskBottom.gbr, debug_board_v1-MaskTop.gbr, debug_board_v1-NPTH.drl, debug_board_v1-PTH.drl, debug_board_v1-SilkBottom.gbr]
2026-09-02 Created Antenna Board V2c Project and Removed LiDAR Sensor
    [104031-0811.SchLib, 104031-0811.stp, 1040310811.PcbLib, 1040310811.psm, 105164-0001.step, 504050-0291.step, AZ1117CH-3.3TRG1.SchLib, AZ1117CH-3.3TRG1.stp]
2026-09-02 Removed Legacy RBF Holes
    [antenna_top_cap_v2c.kicad_pcb, antenna_top_cap_v2c.kicad_sch]
2026-11-09 Create Antenna Board V2d Project
    Copy of antenna_top_cap_v2c with the project renamed. Stale v2b/v2c
    gerbers and the GUI lock files are not carried over.
2026-11-09 V2d: Add USB charger and SWD pass-through
    Charger: BQ25886 standalone 2S boost charger fed from J12 "FC USB"
    VBUS, 5 V only (no PD contract). ICHG 1.02 A, input limit 1.35 A,
    8.2 V float, fixed TS divider, OTG and /CE tied low, D+ tied to D-.
    Output goes through a 2 A fuse and a removable CHG LINK header (J203)
    onto Dir_Chrg_In, the raw pack +. Green LED shows USB 5 V, red shows
    STAT. New sheet charger_swd.kicad_sch, generated by
    tools/gen_charger_sheet.py.
    SWD: J201 (inner face) wired 1:1 to J202 (outer face), JST-SH
    BM03B-SRSS-TB, same pinout as FC J22.
    Layout is scripted (tools/build_board.sh: place_charger.py then
    route_charger.py from the V2c board). Production files written with
    tool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
2026-11-09 V2d: Dedicated charge USB-C and review fixes
    Michael asked for a third USB-C instead of charging through J12, so a
    laptop debug session never feeds the charger. J204 is charge-only
    (5.1k Rd on CC, data pins open); J12 is back to V2c (VBUS open).
    Fixes from the independent schematic/layout review:
    - SYS and BAT caps are 22 uF 25 V 1206 (about 14 uF each at 8.2 V);
    SYS has 42 uF after derating.
    - SYS cap grounds are tied with solid copper and a via each; the EP
    has four vias; EP and cap grounds use solid zone connections.
    - Bootstrap cap C208 moved under the SW/BTST pins on the outer face.
    - CHG LINK J203 is now 2.0 mm pitch so its shunt cannot fit J2
    (pack + to GND).
    - USB LED resistor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
2026-11-11 V2d: F201 to 1.5 A and record the fault-loop estimate
    1.02 A charge is 68 % of the rating and 1.5 A protects the single
    24 AWG Dir_Chrg_In conductor. Estimated pack-to-short loop is 150 to
    250 mOhm (34 to 56 A at 8.4 V), at or under the 50 A interrupt rating.
2026-11-11 V2d: JLC dry-run fixes, fit check, EP via ruling
    - BOM grouped by LCSC number so JLC's matcher keeps shared parts
    (J8/J12/J204, J201/J202) selected.
    - U201 rotation correction is 0, not +270 (JLC preview showed the
    pin-1 dot top-right at +270).
    - DECISIONS: Onshape fit check, JLC quote and preview results,
    EP vias accepted.
2026-11-11 V2d: Tidy overlapping schematic labels
    J204 reference/value moved off the header notes, R208/R209 spread
    apart with the VBUS wire moved right, LED labels clear of the LED
    symbols. Netlist unchanged; ERC and sch_lint unchanged; board rebuilt
    for the new symbol paths (DRC unchanged).
2026-11-12 V2d: CHG LINK is a 0 Ohm 1206 (R210) instead of a header
    Michael's call: a JLC-assembled 0 Ohm on the outer face that teams
    hot-air off before handoff. No shunt to lose or push onto J2. Vias
    carry CHG_FUSED down to it and Dir_Chrg_In back up to the existing
    track. ERC and DRC unchanged (0 new).
2026-11-12 V2d: J9/J11 to DF11-4DP-2DSA(08), in stock at JLC
    The (24) suffix (C2692098) is out of stock; (08) (C506665) is the
    same header, footprint and pinout.
2026-11-12 V2d: U4 to the UMW TMP112AIDRLR second source (C3019122)
    All genuine TI SOT-563 TMP112 variants are at 0 or near 0 stock at JLC.
    Same footprint; DRC unchanged.
2026-11-12 V2d silk: R210 on pre-flight list, refs off pads, 0.8 mm labels
